crankery/lamarama/src/resource_extractor/extract/monk-strip.png

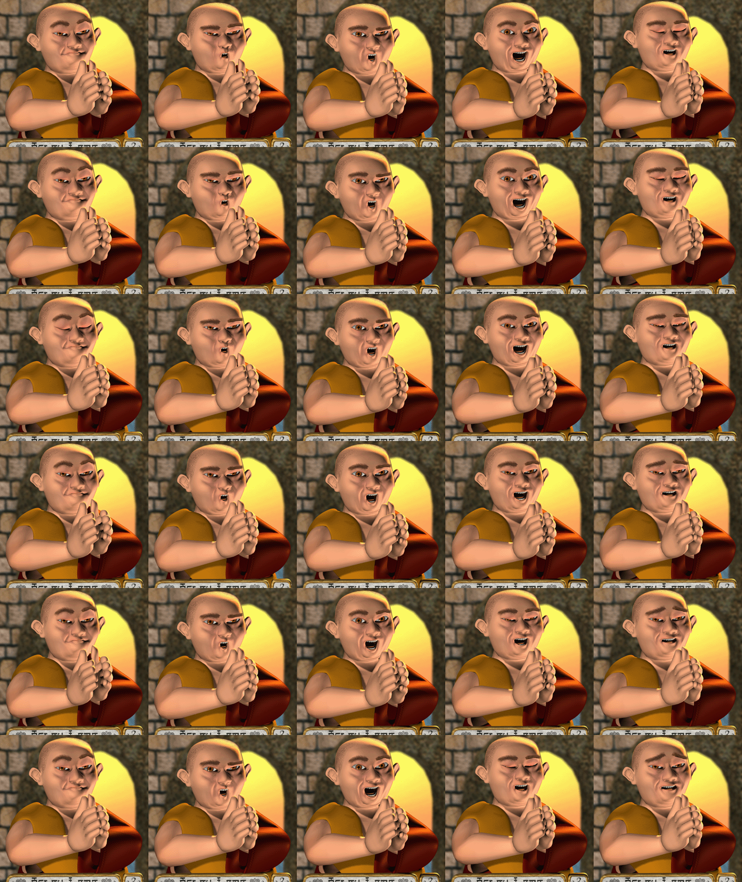
src/resource_extractor/extract/monk-strip.png
