crankery/lamarama/src/resource_extractor/extract/background.png

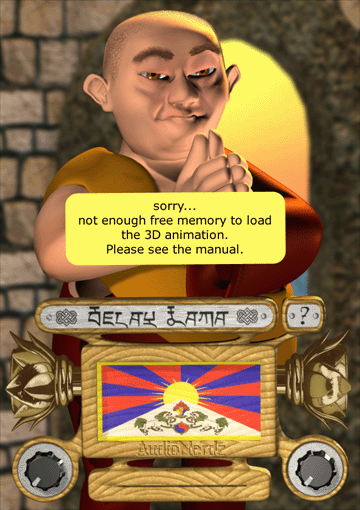
src/resource_extractor/extract/background.png
