crankery/lamarama/hw/docs/lcd.png

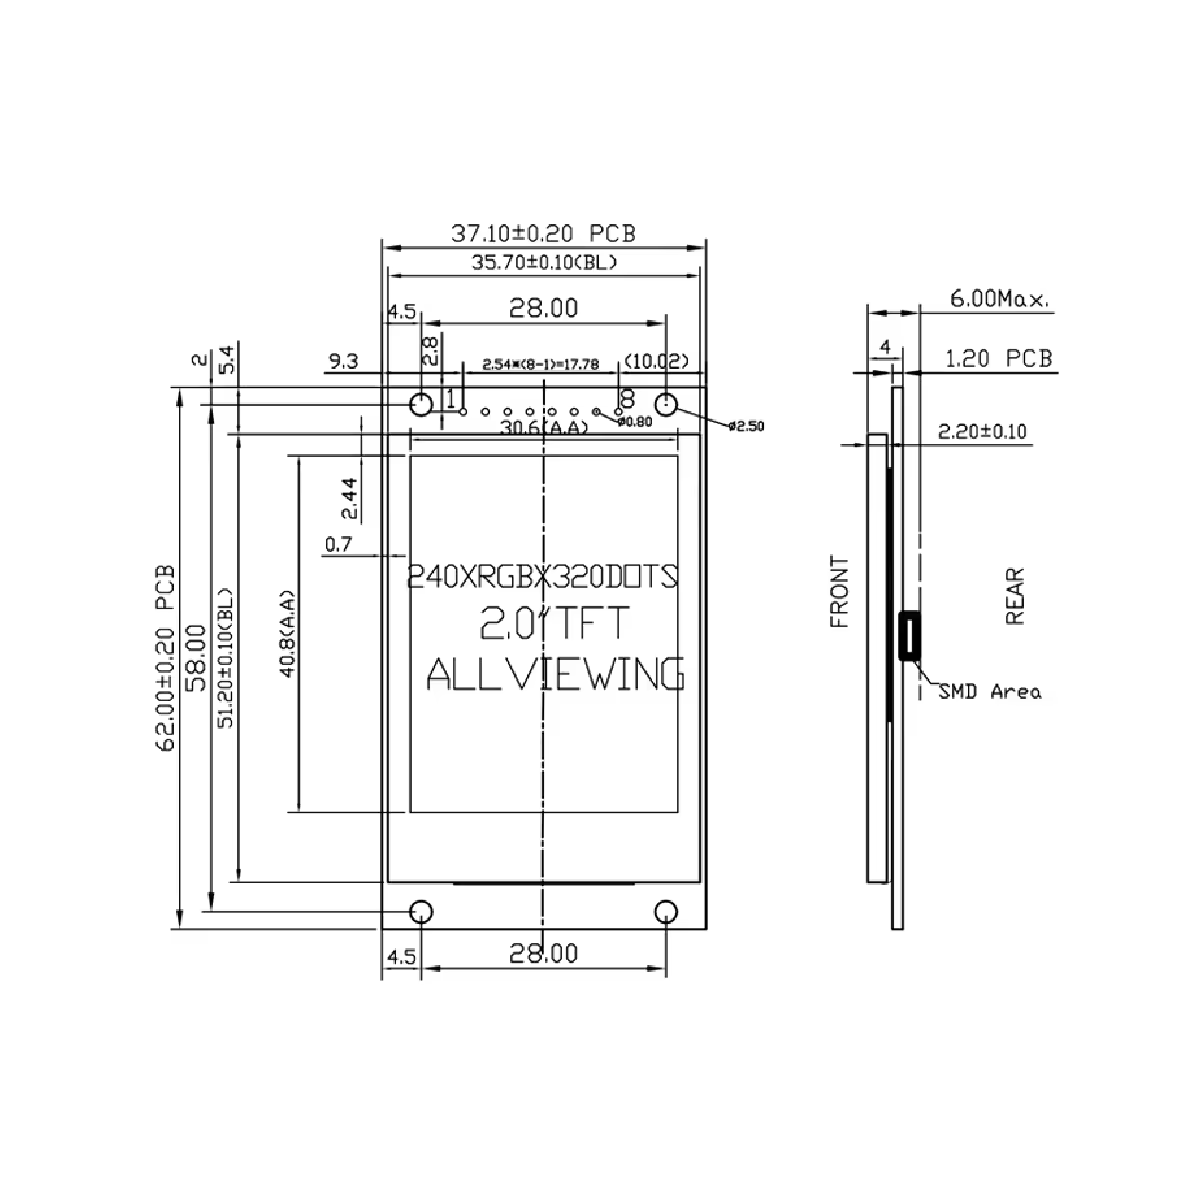
hw/docs/lcd.png
