crankery/lamarama/resources/Smug Scheming Monk Line Art.png

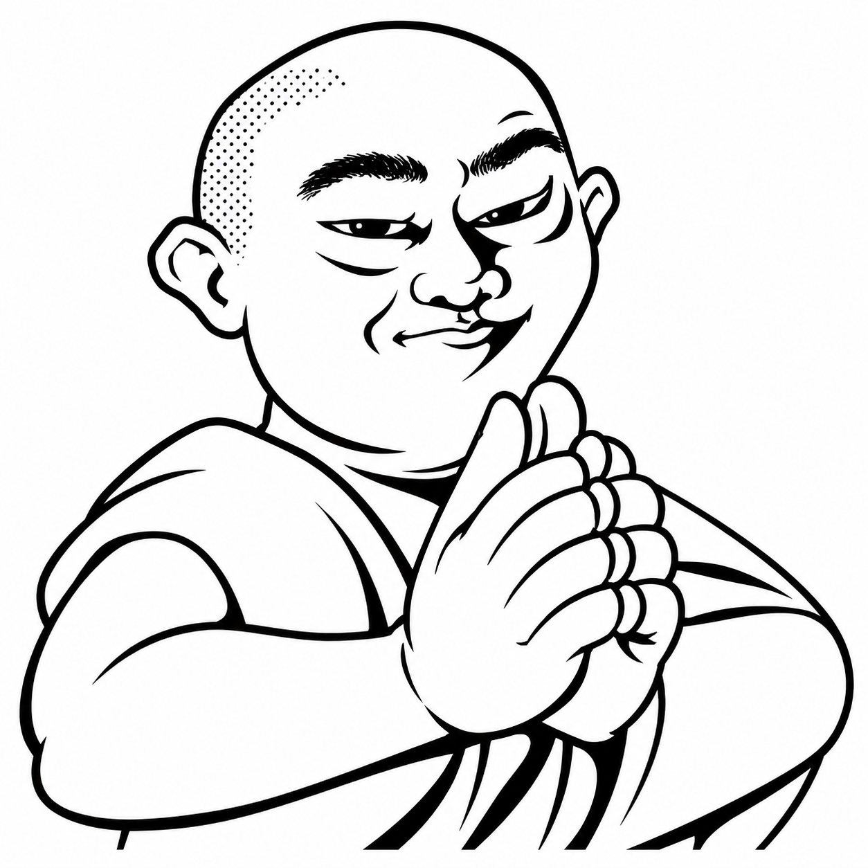
resources/Smug Scheming Monk Line Art.png
