crankery/lamarama/src/resource_extractor/extract/info.png

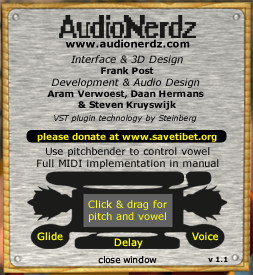
src/resource_extractor/extract/info.png
