crankery/lamarama/hw/3D/main.step

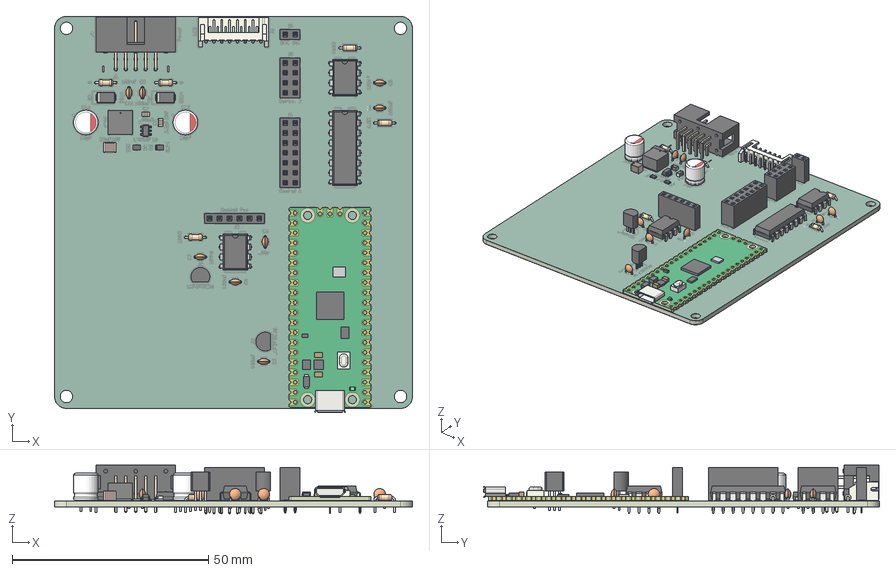
[picture p6: CAD file, 2026-10-27]
hw/3D/main.step
91.3 x 101.1 x 12.5 mm
PinSocket_2x07_P2.54mm_Vertical
C_Disc_D30mm_W16mm_P250mm x 8
D_SMA x 2
R_Axial_DIN0204_L36mm_D16mm_P508mm_Horizontal x 5
DIP-16_W7.62mm
R_0805_2012Metric x 2
JST_S8B_PH_K
C_0805_2012Metric x 2
RaspberryPi_Pico_Module_KiCad
TO-92_Inline_Narrow x 2
CAPPRD250W45D630H700_Nichicon-NS x 2
SOT-23-6
DIP-8_W7.62mm x 2
PinSocket_1x02_P2.54mm_Vertical
PinSocket_2x04_P2.54mm_Vertical
IDC_Header_2x05_P254mm_Horizontal
PinSocket_1x06_P2.54mm_Vertical
C_1210_3225Metric
main_silkscreen
main_soldermask x 2
main_PCB
