crankery/lamarama/hw/3D/fp.step

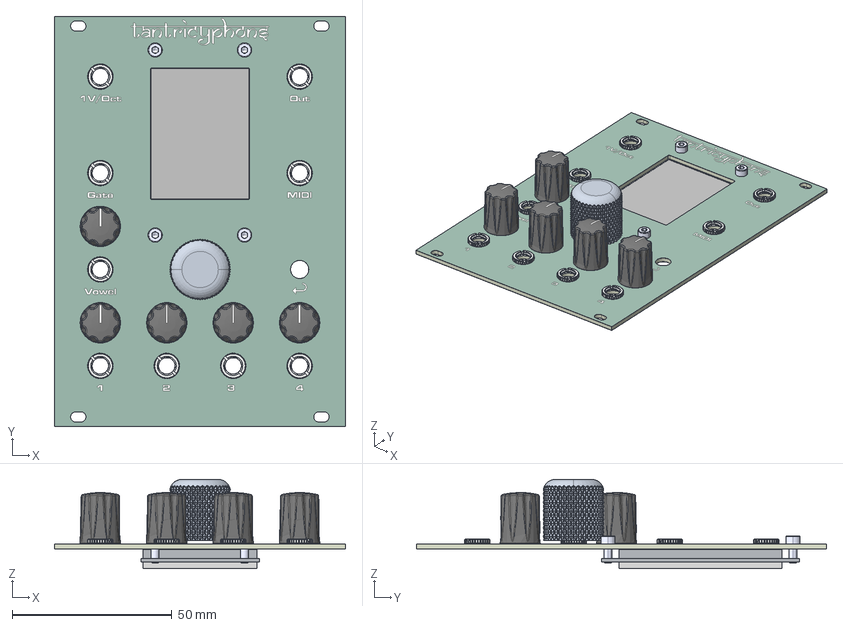
[picture p7: CAD file, 2026-10-29]
hw/3D/fp.step
91.3 x 128.5 x 28.0 mm
Dome Knob Allparts
KNUT-PJ398SM x 9
1900h-bk-T-D x 5
din912-m2.5x6 x 4
fp_silkscreen
fp_soldermask x 2
fp_PCB
