crankery/lamarama/hw/3D/Dome Knob Allparts.STEP

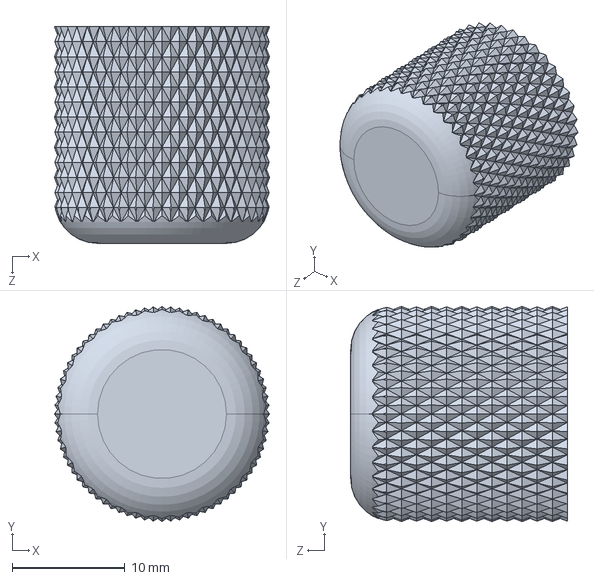
[picture p8: CAD file, 2026-10-29]
hw/3D/Dome Knob Allparts.STEP
19.1 x 19.1 x 19.2 mm
