crankery/lamarama/hw/3D/encoderknob.step

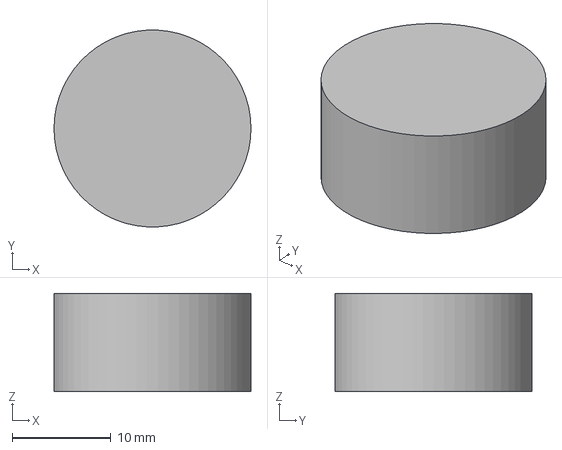
[picture p9: CAD file, 2026-10-29]
hw/3D/encoderknob.step
20.0 x 20.0 x 10.0 mm
