crankery/lamarama/hw/3D/display.step

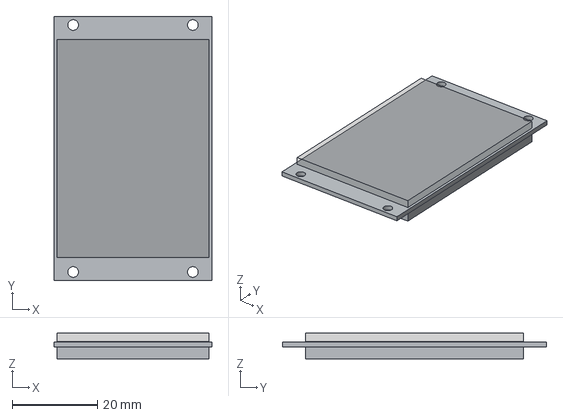
[picture p10: CAD file, 2026-10-29]
hw/3D/display.step
37.1 x 62.0 x 6.01 mm
