crankery/lamarama/hw/3D/RM065.stp

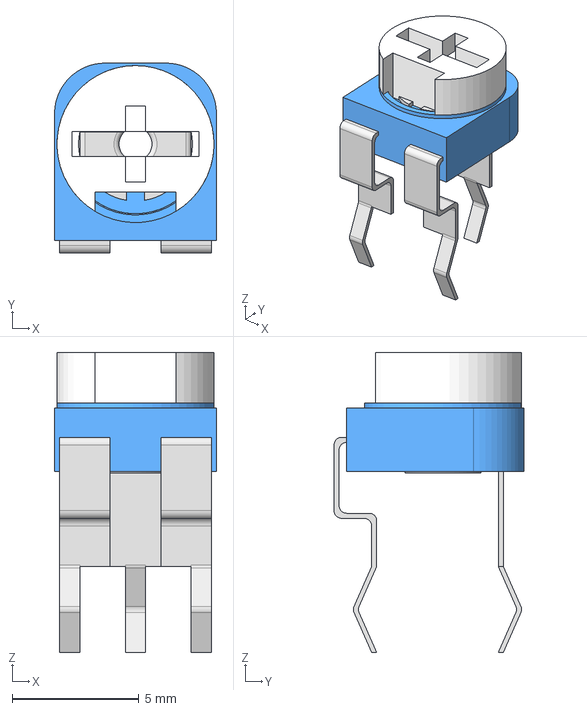
[picture p11: CAD file, 2026-10-29]
hw/3D/RM065.stp
6.40 x 7.50 x 11.9 mm
