crankery/lamarama/hw/3D/control.step

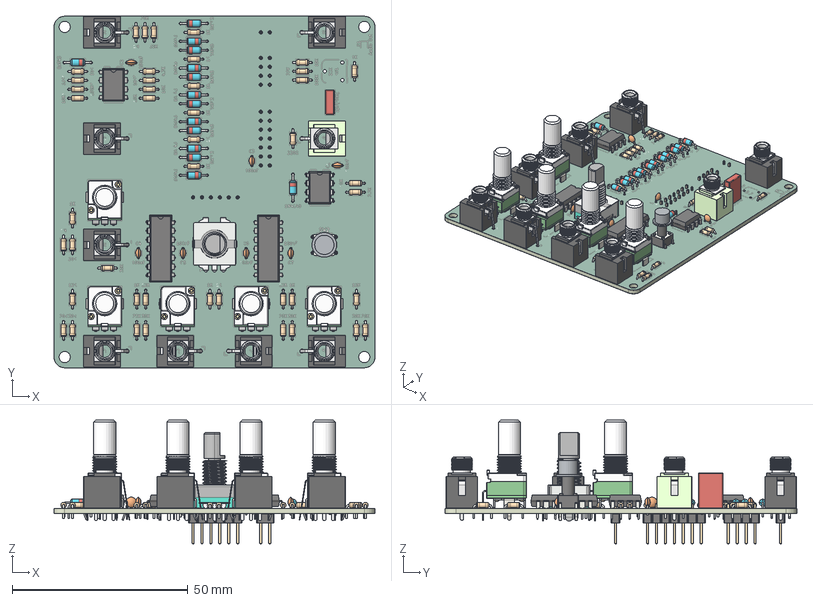
[picture p12: CAD file, 2026-10-29]
hw/3D/control.step
91.3 x 100.0 x 35.2 mm
R_Axial_DIN0204_L36mm_D16mm_P508mm_Horizontal x 44
Pin_3 x 8
Pin_2 x 8
Pin_1 x 8
Socket x 9
D_DO-35_SOD27_P7.62mm_Horizontal x 14
C_Disc_D30mm_W16mm_P250mm x 7
Pin 3
Pin 2
Pin 1
RD901F-40-15R1 v9 x 5
DIP-8_W7.62mm x 2
C_Rect_L70mm_W25mm_P500mm
SW_PUSH_6mm_h13mm
ѽת±ძǷ
DIP-14_W7.62mm x 2
PinHeader_2x04_P254mm_Vertical
PinHeader_1x02_P254mm_Vertical
PinHeader_2x07_P254mm_Vertical
PinHeader_1x06_P254mm_Vertical
control_silkscreen x 2
control_soldermask x 2
control_PCB
