crankery/lamarama/hw/3D/PJ398SM.STEP

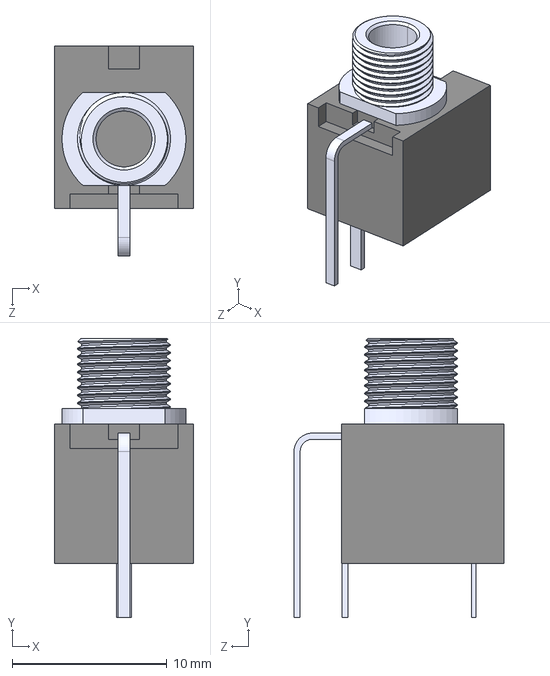
[picture p13: CAD file, 2026-10-27]
hw/3D/PJ398SM.STEP
9.00 x 18.0 x 13.5 mm
