crankery/lamarama/hw/3D/a101.FCStd

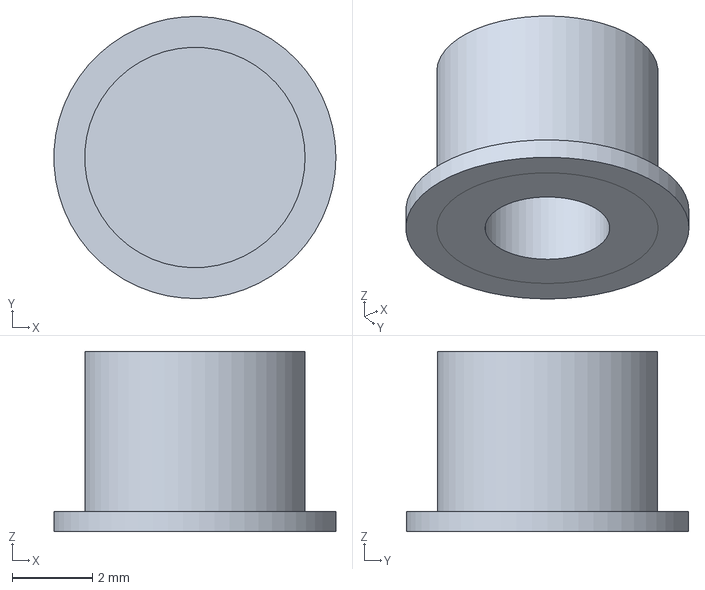
[picture p14: CAD file, 2026-10-27]
hw/3D/a101.FCStd
7.03 x 7.04 x 4.50 mm
