crankery/lamarama/hw/3D/IND_IFSC-2020DE-01_VIS.step

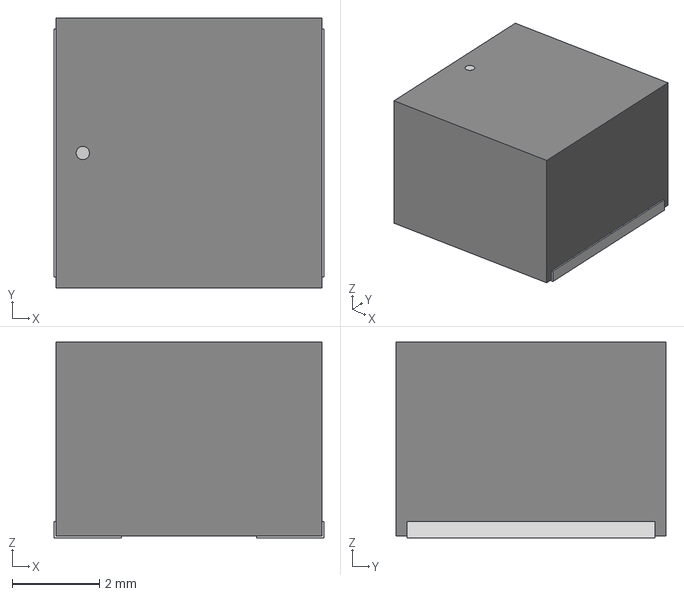
[picture p15: CAD file, 2026-10-27]
hw/3D/IND_IFSC-2020DE-01_VIS.step
6.20 x 6.20 x 4.50 mm
