crankery/lamarama/hw/3D/CAPPRD250W45D630H700_Nichicon-NS.stp

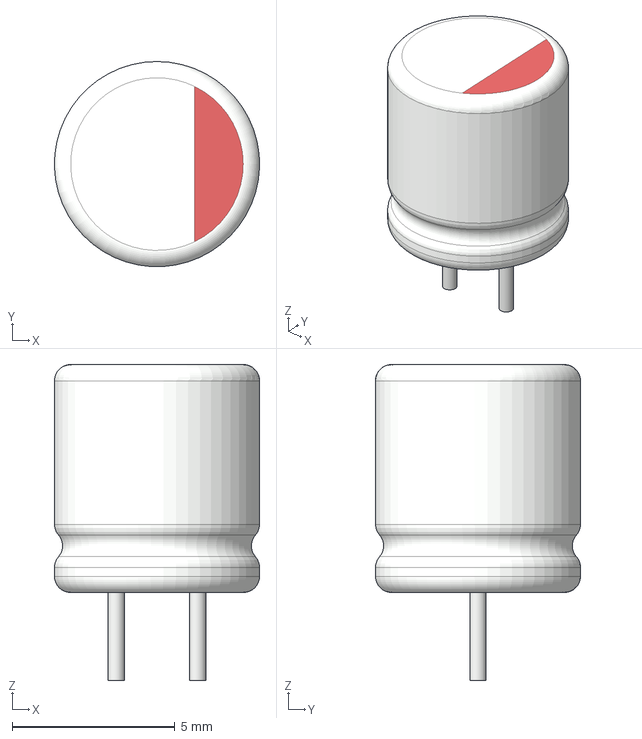
[picture p16: CAD file, 2026-10-27]
hw/3D/CAPPRD250W45D630H700_Nichicon-NS.stp
6.30 x 6.29 x 9.70 mm
