crankery/lamarama/hw/3D/din912-m2.5x6.STEP

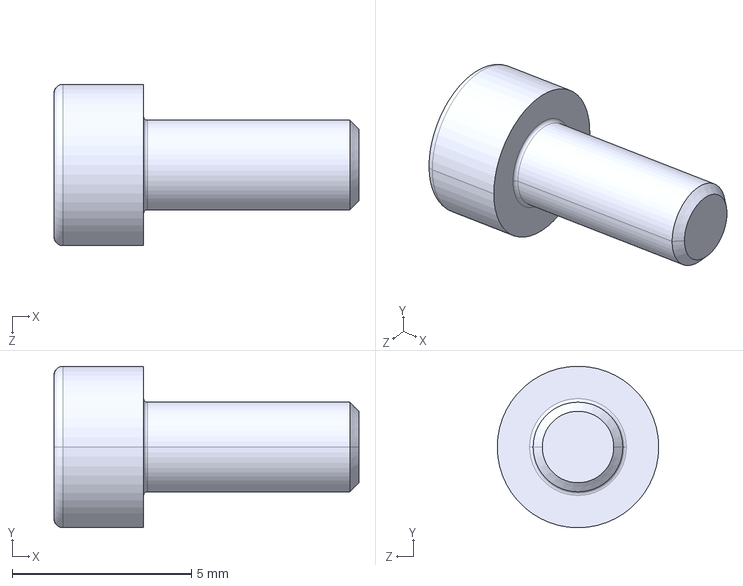
[picture p17: CAD file, 2026-10-29]
hw/3D/din912-m2.5x6.STEP
8.50 x 4.50 x 4.50 mm
