crankery/lamarama/hw/3D/encoderknob.scad

$fn = 32;

color("grey")
  cylinder(h = 10, r = 10);
