crankery/lamarama/(list of files, cad)

Other CAD files:
hw/3D/Unnamed-difference.step
hw/3D/a101.stl
