crankery/lamarama/hw/control/control.kicad_pcb

## KiCad design hw/control/control.kicad_pcb (2026-10-29)

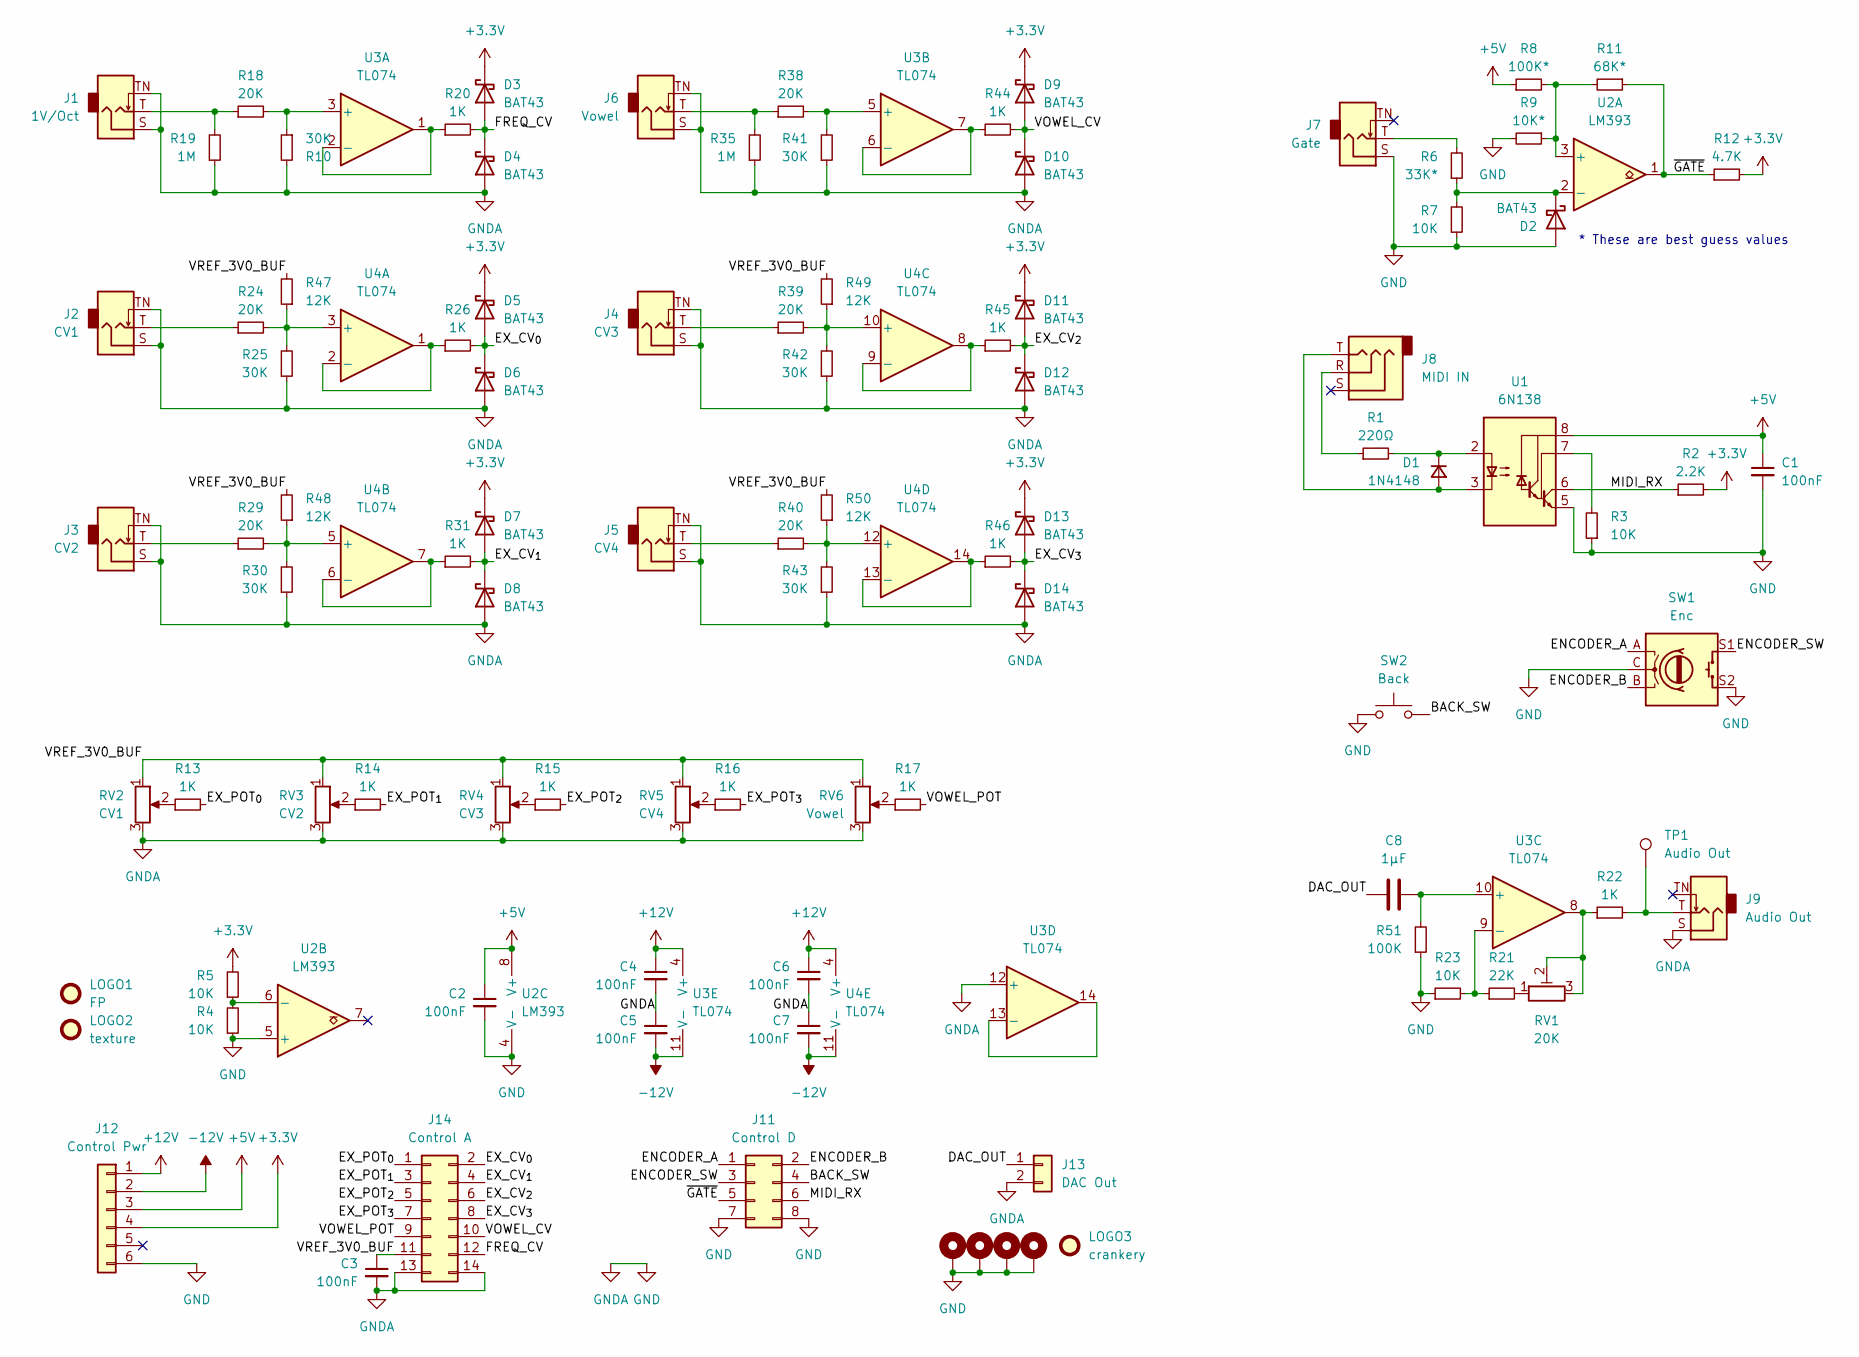
[picture p18: schematic control.kicad_sch]

Parts:
C1, C2, C3, C4, C5, C6, C7: 100nF; C_Disc_D3.0mm_W1.6mm_P2.50mm
C8: 1µF; C_Rect_L7.0mm_W2.5mm_P5.00mm
D1: 1N4148; D_DO-35_SOD27_P7.62mm_Horizontal
D2, D3, D4, D5, D6, D7, D8, D9, D10, D11, D12, D13, D14: BAT43; D_DO-35_SOD27_P7.62mm_Horizontal
H1, H2, H3, H4: MountingHole_Pad; MountingHole_3.2mm_M3_DIN965_Pad
J1: 1V/Oct; Jack_PJ398SM
J2: CV1; Jack_PJ398SM
J3: CV2; Jack_PJ398SM
J4: CV3; Jack_PJ398SM
J5: CV4; Jack_PJ398SM
J6: Vowel; Jack_PJ398SM
J7: Gate; Jack_PJ398SM
J8: MIDI IN; Jack_P419_GR
J9: Audio Out; Jack_PJ398SM
J11: Control D; PinHeader_2x04_P2.54mm_Vertical
J12: Control Pwr; PinHeader_1x06_P2.54mm_Vertical
J13: DAC Out; PinHeader_1x02_P2.54mm_Vertical
J14: Control A; PinHeader_2x07_P2.54mm_Vertical
LOGO1: FP; fp
LOGO2: texture; hammeredx
LOGO3: crankery; crankery_small
R1: 220Ω; R_Axial_DIN0204_L3.6mm_D1.6mm_P5.08mm_Horizontal
R2: 2.2K; R_Axial_DIN0204_L3.6mm_D1.6mm_P5.08mm_Horizontal
R3, R4, R5, R7, R23: 10K; R_Axial_DIN0204_L3.6mm_D1.6mm_P5.08mm_Horizontal
R6: 33K*; R_Axial_DIN0204_L3.6mm_D1.6mm_P5.08mm_Horizontal
R8: 100K*; R_Axial_DIN0204_L3.6mm_D1.6mm_P5.08mm_Horizontal
R9: 10K*; R_Axial_DIN0204_L3.6mm_D1.6mm_P5.08mm_Horizontal
R10, R25, R30, R41, R42, R43: 30K; R_Axial_DIN0204_L3.6mm_D1.6mm_P5.08mm_Horizontal
R11: 68K*; R_Axial_DIN0204_L3.6mm_D1.6mm_P5.08mm_Horizontal
R12: 4.7K; R_Axial_DIN0204_L3.6mm_D1.6mm_P5.08mm_Horizontal
R13, R14, R15, R16, R17, R20, R22, R26, R31, R44, R45, R46: 1K; R_Axial_DIN0204_L3.6mm_D1.6mm_P5.08mm_Horizontal
R18, R24, R29, R38, R39, R40: 20K; R_Axial_DIN0204_L3.6mm_D1.6mm_P5.08mm_Horizontal
R19, R35: 1M; R_Axial_DIN0204_L3.6mm_D1.6mm_P5.08mm_Horizontal
R21: 22K; R_Axial_DIN0204_L3.6mm_D1.6mm_P5.08mm_Horizontal
R47, R48, R49, R50: 12K; R_Axial_DIN0204_L3.6mm_D1.6mm_P5.08mm_Horizontal
R51: 100K; R_Axial_DIN0204_L3.6mm_D1.6mm_P5.08mm_Horizontal
RV1: 20K; Potentiometer_Runtron_RM-065_Vertical
RV2: CV1; Potentiometer_Alpha_RD901F-40-00D_Single_Vertical
RV3: CV2; Potentiometer_Alpha_RD901F-40-00D_Single_Vertical
RV4: CV3; Potentiometer_Alpha_RD901F-40-00D_Single_Vertical
RV5: CV4; Potentiometer_Alpha_RD901F-40-00D_Single_Vertical
RV6: Vowel; Potentiometer_Alpha_RD901F-40-00D_Single_Vertical
SW1: Enc; RotaryEncoder_Alps_EC11E-Switch_Vertical_H20mm
SW2: Back; SW_PUSH_6mm_H13mm
TP1: Audio Out; TestPoint_Pad_1.5x1.5mm
U1: 6N138; DIP-8_W7.62mm
U2: LM393; DIP-8_W7.62mm
U3, U4: TL074; DIP-14_W7.62mm

Connections:
+3.3V: D3.1 (K), D5.1 (K), D7.1 (K), D9.1 (K), D11.1 (K), D13.1 (K), J12.4, R2.2, R5.2, R12.2
+5V: C1.1, C2.1, J12.3, R8.1, U1.8 (VCC), U2.8 (V+)
+12V: C4.1, C6.1, J12.1, U3.4 (V+), U4.4 (V+)
-12V: C5.2, C7.2, J12.2, U3.11 (V-), U4.11 (V-)
/BACK_SW: J11.4, SW2.2
/DAC_OUT: C8.1, J13.1
/ENCODER_A: J11.1, SW1.A
/ENCODER_B: J11.2, SW1.B
/ENCODER_SW: J11.3, SW1.S1
/EX_CV_{0}: D5.2 (A), D6.1 (K), J14.2, R26.2
/EX_CV_{1}: D7.2 (A), D8.1 (K), J14.4, R31.2
/EX_CV_{2}: D11.2 (A), D12.1 (K), J14.6, R45.2
/EX_CV_{3}: D13.2 (A), D14.1 (K), J14.8, R46.2
/EX_POT_{0}: J14.1, R13.2
/EX_POT_{1}: J14.3, R14.2
/EX_POT_{2}: J14.5, R15.2
/EX_POT_{3}: J14.7, R16.2
/FREQ_CV: D3.2 (A), D4.1 (K), J14.12, R20.2
/MIDI_RX: J11.6, R2.1, U1.6 (VO2)
/VOWEL_CV: D9.2 (A), D10.1 (K), J14.10, R44.2
/VOWEL_POT: J14.9, R17.2
/VREF_3V0_BUF: C3.1, J14.11, R47.2, R48.2, R49.2, R50.2, RV2.1, RV3.1, RV4.1, RV5.1, RV6.1
/~GATE: J11.5, R11.1, R12.1, U2.1
GND: C1.2, C2.2, C3.2, C4.2, C5.1, C6.2, C7.1, D2.2 (A), D4.2 (A), D6.2 (A), D8.2 (A), D10.2 (A), D12.2 (A), D14.2 (A), H1.1 (1_1), H2.1 (1_1), H3.1 (1_1), H4.1 (1_1), J1.S, J1.TN, J2.S, J2.TN, J3.S, J3.TN, J4.S, J4.TN, J5.S, J5.TN, J6.S, J6.TN, J7.S, J9.S, J11.7, J11.8, J12.6, J13.2, J14.13, J14.14, R3.1, R4.1, R7.1, R9.2, R10.2, R19.1, R23.1, R25.1, R30.1, R35.1, R41.1, R42.1, R43.1, R51.1, RV2.3, RV3.3, RV4.3, RV5.3, RV6.3, SW1.C, SW1.S2, SW2.1, U1.5 (GND), U2.4 (V-), U2.5 (+), U3.12 (+)
unnamed: D1.2 (A), J8.T, U1.3 (C2)
unnamed: D1.1 (K), R1.2, U1.2 (C1)
unnamed: D2.1 (K), R6.1, R7.2, U2.2 (-)
unnamed: J1.T, R18.1, R19.2
unnamed: J2.T, R24.1
unnamed: J3.T, R29.1
unnamed: J4.T, R39.1
unnamed: J5.T, R40.1
unnamed: J6.T, R35.2, R38.1
unnamed: J7.T, R6.2
unnamed: J8.R, R1.1
unnamed: J9.T, R22.2, TP1.1 (1_1)
unnamed: R13.1, RV2.2
unnamed: R14.1, RV3.2
unnamed: R15.1, RV4.2
unnamed: R16.1, RV5.2
unnamed: R17.1, RV6.2
unnamed: R21.2, RV1.1
unnamed: R22.1, RV1.2, RV1.3, U3.8
unnamed: R3.2, U1.7 (VO1)
unnamed: R8.2, R9.1, R11.2, U2.3 (+)
unnamed: R4.2, R5.1, U2.6 (-)
unnamed: R10.1, R18.2, U3.3 (+)
unnamed: R20.1, U3.1, U3.2 (-)
unnamed: R38.2, R41.2, U3.5 (+)
unnamed: R44.1, U3.6 (-), U3.7
unnamed: C8.2, R51.2, U3.10 (+)
unnamed: R21.1, R23.2, U3.9 (-)
unnamed: U3.13 (-), U3.14
unnamed: R24.2, R25.2, R47.1, U4.3 (+)
unnamed: R26.1, U4.1, U4.2 (-)
unnamed: R29.2, R30.2, R48.1, U4.5 (+)
unnamed: R31.1, U4.6 (-), U4.7
unnamed: R39.2, R42.2, R49.1, U4.10 (+)
unnamed: R45.1, U4.8, U4.9 (-)
unnamed: R40.2, R43.2, R50.1, U4.12 (+)
unnamed: R46.1, U4.13 (-), U4.14

Notes on the sheet:
* These are best guess values

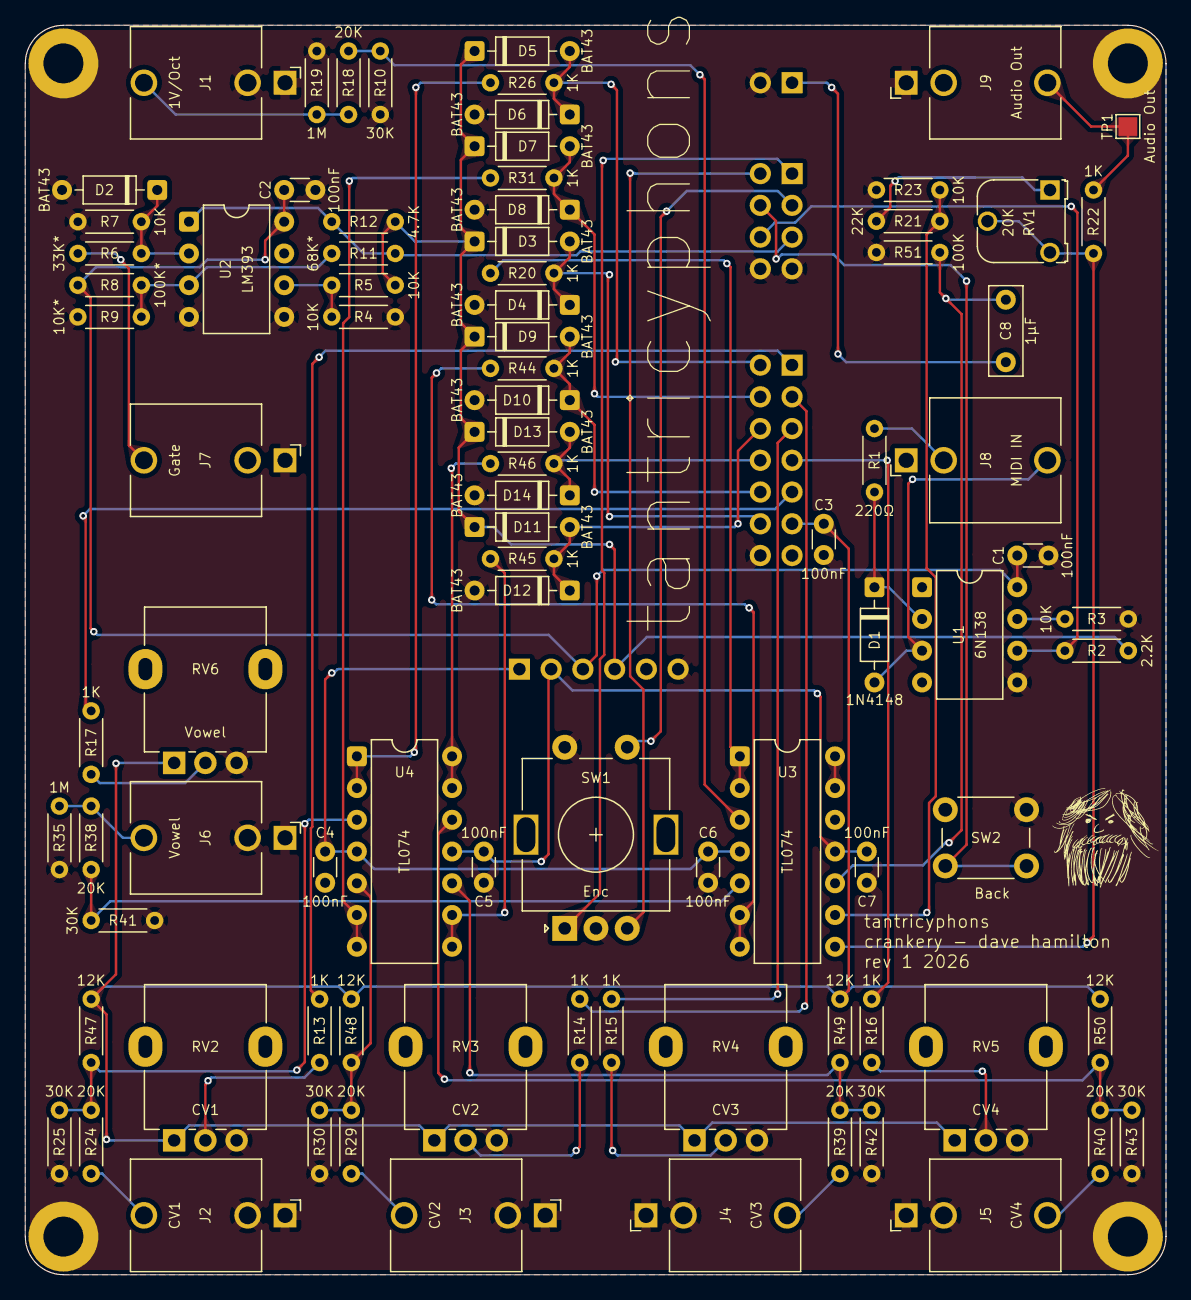
[picture p19: board control.kicad_pcb from above]

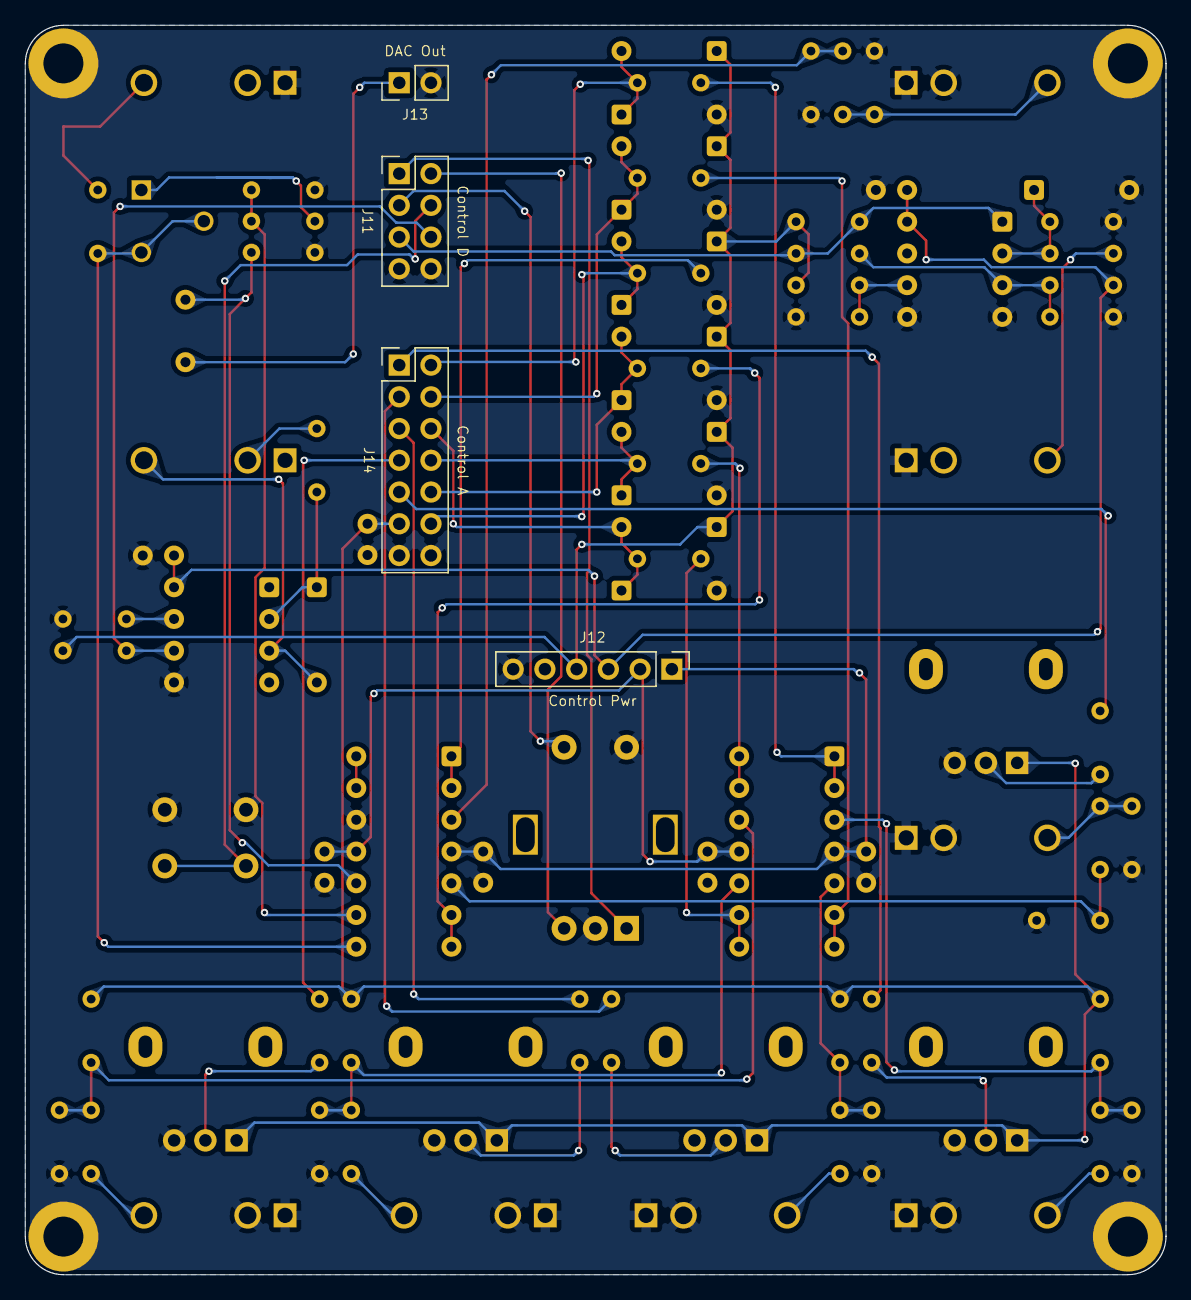
[picture p20: board control.kicad_pcb from below]

Board: 2 copper layers, 91.3 x 100.0 mm, 98 parts (4 on the bottom side), 61 nets.
