crankery/lamarama/hw/main/main.kicad_pcb

## KiCad design hw/main/main.kicad_pcb (2026-10-29)

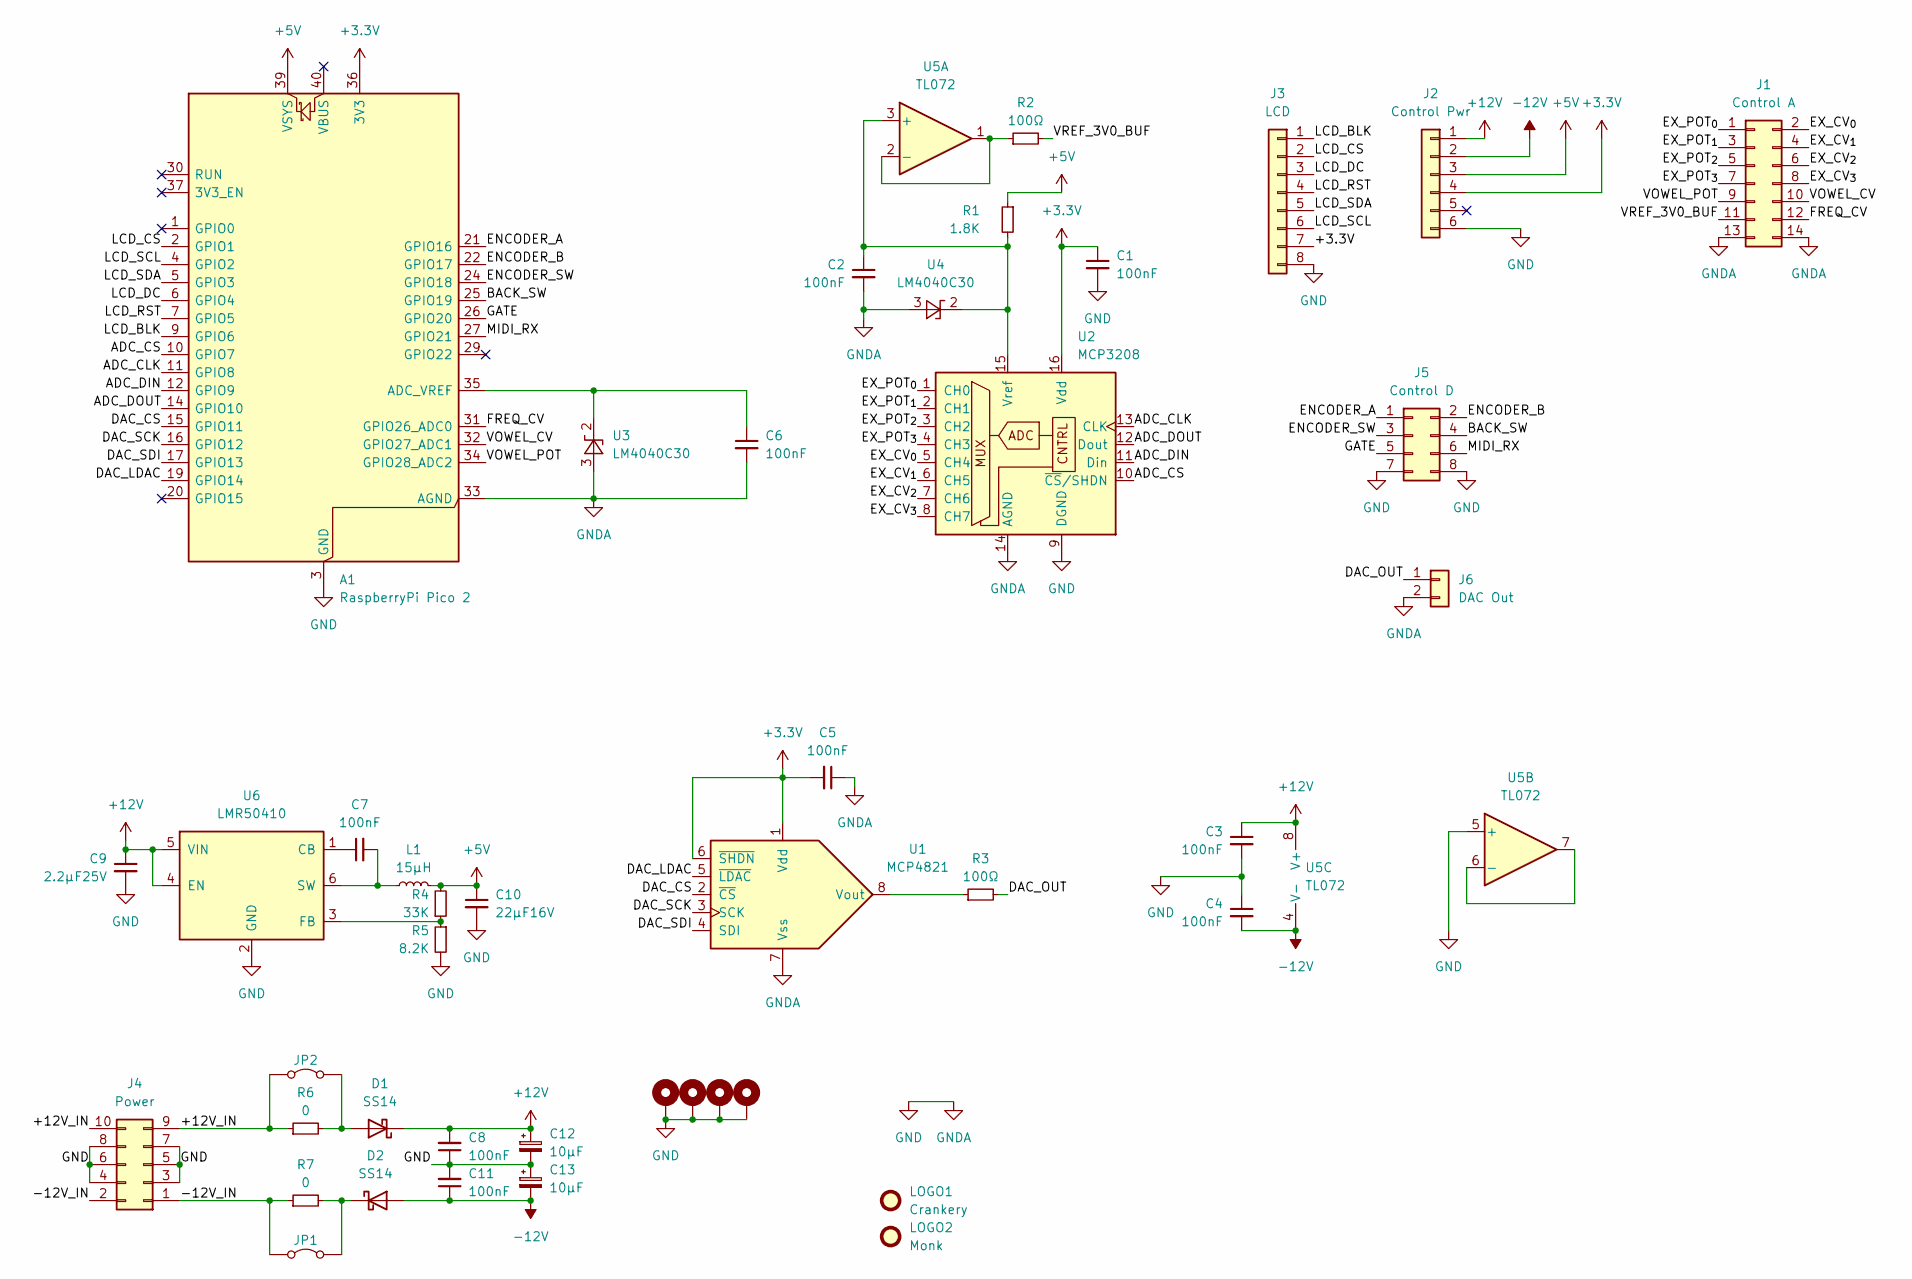
[picture p21: schematic main.kicad_sch]

Parts:
A1: RaspberryPi Pico 2; RaspberryPi_Pico_SMD
C1, C2, C3, C4, C5, C6, C8, C11: 100nF; C_Disc_D3.0mm_W1.6mm_P2.50mm
C7: 100nF; C_0805_2012Metric_Pad1.18x1.45mm_HandSolder
C9: 2.2µF25V; C_0805_2012Metric_Pad1.18x1.45mm_HandSolder
C10: 22µF16V; C_1210_3225Metric_Pad1.33x2.70mm_HandSolder
C12, C13: 10µF; CP_Radial_D6.3mm_P2.50mm
D1, D2: SS14; D_SMA
H1, H2, H3, H4: MountingHole_Pad; MountingHole_3.2mm_M3_DIN965_Pad
J1: Control A; PinSocket_2x07_P2.54mm_Vertical
J2: Control Pwr; PinSocket_1x06_P2.54mm_Vertical
J3: LCD; JST_PH_S8B-PH-K_1x08_P2.00mm_Horizontal
J4: Power; IDC-Header_2x05_P2.54mm_Horizontal
J5: Control D; PinSocket_2x04_P2.54mm_Vertical
J6: DAC Out; PinSocket_1x02_P2.54mm_Vertical
JP1, JP2: Jumper_2_Bridged; SolderJumper-2_P1.3mm_Bridged_RoundedPad1.0x1.5mm
L1: 15µH; L_TDK_VLS6045EX_VLS6045AF
LOGO1: Crankery; crankery_small
LOGO2: Monk; monk
R1: 1.8K; R_Axial_DIN0204_L3.6mm_D1.6mm_P5.08mm_Horizontal
R2, R3: 100Ω; R_Axial_DIN0204_L3.6mm_D1.6mm_P5.08mm_Horizontal
R4: 33K; R_0805_2012Metric_Pad1.20x1.40mm_HandSolder
R5: 8.2K; R_0805_2012Metric_Pad1.20x1.40mm_HandSolder
R6, R7: 0; R_Axial_DIN0204_L3.6mm_D1.6mm_P5.08mm_Horizontal
U1: MCP4821; DIP-8_W7.62mm
U2: MCP3208; DIP-16_W7.62mm
U3, U4: LM4040C30; TO-92_Inline
U5: TL072; DIP-8_W7.62mm
U6: LMR50410; SOT-23-6

Connections:
+3.3V: A1.36 (3V3), C1.1, C5.2, J2.4, J3.7, U1.1 (Vdd), U1.6 (~SHDN), U2.16 (Vdd)
+5V: A1.39 (VSYS), C10.1, J2.3, L1.2, R1.1, R4.2
+12V: C3.1, C8.2, C9.1, C12.1, D1.1 (K), J2.1, U5.8 (V+), U6.4 (EN), U6.5 (VIN)
-12V: C4.2, C11.1, C13.2, D2.2 (A), J2.2, U5.4 (V-)
/+12V_IN: J4.9, J4.10, JP2.1 (A), R6.1
/-12V_IN: J4.1, J4.2, JP1.1 (A), R7.1
/ADC_CLK: A1.11 (GPIO8), U2.13 (CLK)
/ADC_CS: A1.10 (GPIO7), U2.10 (~CS/SHDN)
/ADC_DIN: A1.12 (GPIO9), U2.11 (Din)
/ADC_DOUT: A1.14 (GPIO10), U2.12 (Dout)
/BACK_SW: A1.25 (GPIO19), J5.4
/DAC_CS: A1.15 (GPIO11), U1.2 (~CS)
/DAC_LDAC: A1.19 (GPIO14), U1.5 (~LDAC)
/DAC_OUT: J6.1, R3.2
/DAC_SCK: A1.16 (GPIO12), U1.3 (SCK)
/DAC_SDI: A1.17 (GPIO13), U1.4 (SDI)
/ENCODER_A: A1.21 (GPIO16), J5.1
/ENCODER_B: A1.22 (GPIO17), J5.2
/ENCODER_SW: A1.24 (GPIO18), J5.3
/EX_CV_{0}: J1.2, U2.5 (CH4)
/EX_CV_{1}: J1.4, U2.6 (CH5)
/EX_CV_{2}: J1.6, U2.7 (CH6)
/EX_CV_{3}: J1.8, U2.8 (CH7)
/EX_POT_{0}: J1.1, U2.1 (CH0)
/EX_POT_{1}: J1.3, U2.2 (CH1)
/EX_POT_{2}: J1.5, U2.3 (CH2)
/EX_POT_{3}: J1.7, U2.4 (CH3)
/FREQ_CV: A1.31 (GPIO26_ADC0), J1.12
/GATE: A1.26 (GPIO20), J5.5
/LCD_BLK: A1.9 (GPIO6), J3.1
/LCD_CS: A1.2 (GPIO1), J3.2
/LCD_DC: A1.6 (GPIO4), J3.3
/LCD_RST: A1.7 (GPIO5), J3.4
/LCD_SCL: A1.4 (GPIO2), J3.6
/LCD_SDA: A1.5 (GPIO3), J3.5
/MIDI_RX: A1.27 (GPIO21), J5.6
/VOWEL_CV: A1.32 (GPIO27_ADC1), J1.10
/VOWEL_POT: A1.34 (GPIO28_ADC2), J1.9
/VREF_3V0_BUF: J1.11, R2.2
GND: A1.3 (GND), A1.8 (GND), A1.13 (GND), A1.18 (GND), A1.23 (GND), A1.28 (GND), A1.33 (AGND), A1.38 (GND), C1.2, C2.2, C3.2, C4.1, C5.1, C6.2, C8.1, C9.2, C10.2, C11.2, C12.2, C13.1, H1.1 (1_1), H2.1 (1_1), H3.1 (1_1), H4.1 (1_1), J1.13, J1.14, J2.6, J3.8, J4.3, J4.4, J4.5, J4.6, J4.7, J4.8, J5.7, J5.8, J6.2, R5.2, U1.7 (Vss), U2.9 (DGND), U2.14 (AGND), U3.3 (A), U4.3 (A), U5.5 (+), U6.2 (GND)
unnamed: A1.35 (ADC_VREF), C6.1, U3.2 (K)
unnamed: D1.2 (A), JP2.2 (B), R6.2
unnamed: D2.1 (K), JP1.2 (B), R7.2
unnamed: R3.1, U1.8 (Vout)
unnamed: C2.1, R1.2, U2.15 (Vref), U4.2 (K), U5.3 (+)
unnamed: R2.1, U5.1, U5.2 (-)
unnamed: U5.6 (-), U5.7
unnamed: C7.1, U6.1 (CB)
unnamed: R4.1, R5.1, U6.3 (FB)
unnamed: C7.2, L1.1, U6.6 (SW)

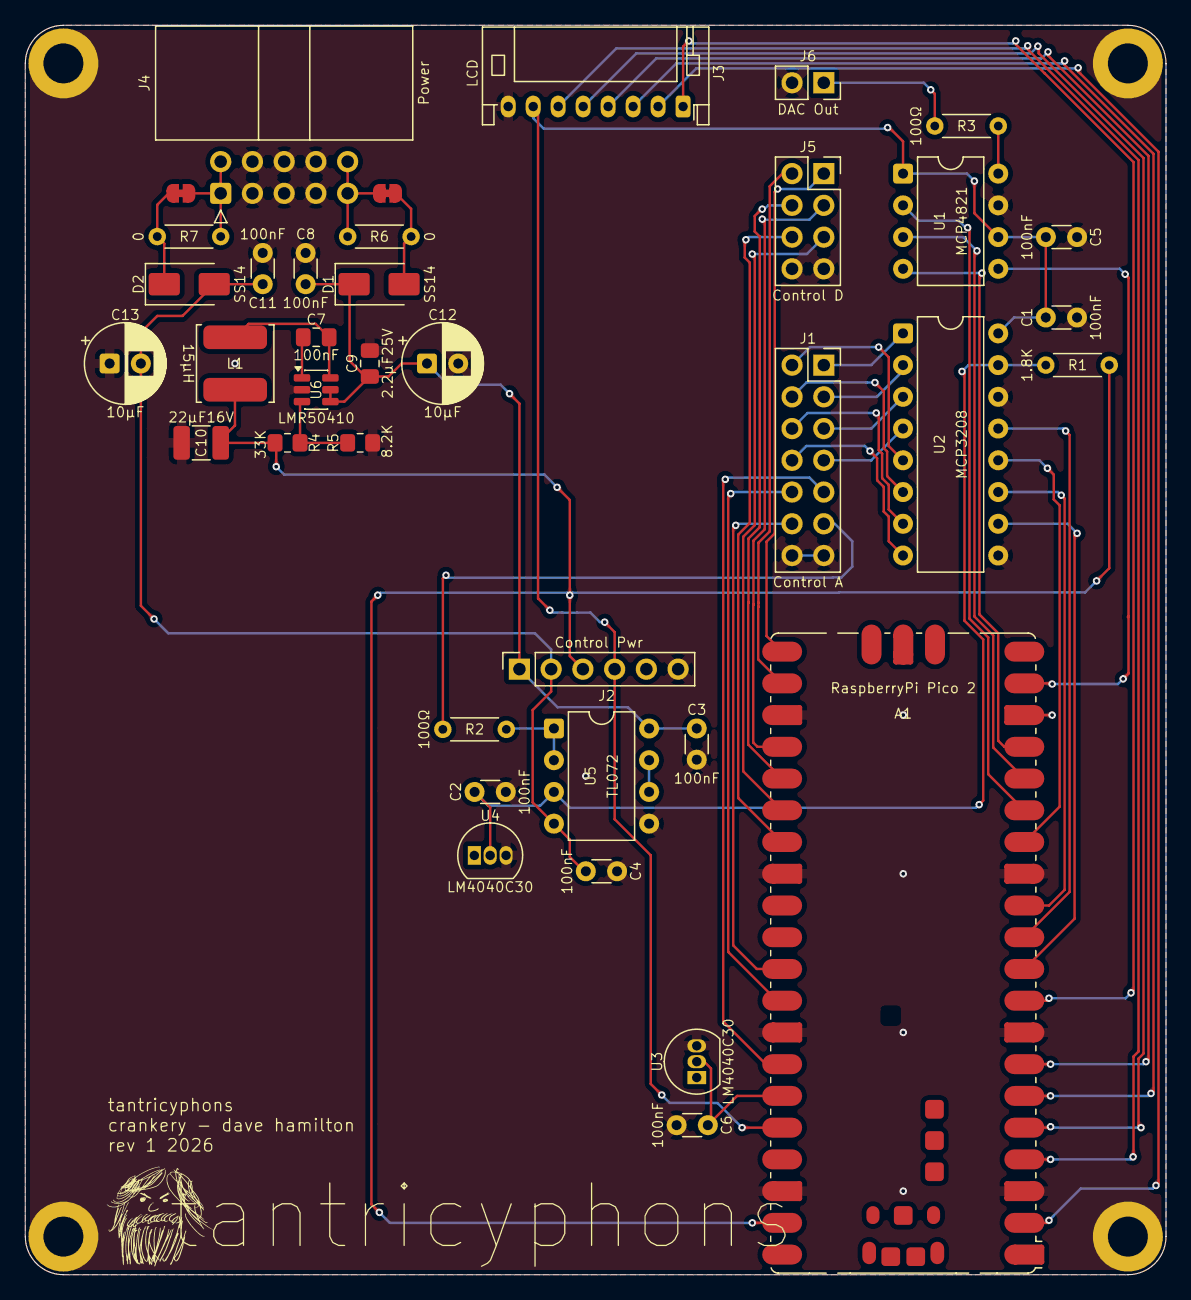
[picture p22: board main.kicad_pcb from above]

Board: 2 copper layers, 91.3 x 100.0 mm, 44 parts (1 on the bottom side), 50 nets.
