crankery/lamarama/src/lama/menu_font.h

/* 8x8 font from st7789_mpy; see assets/font-LICENSE.txt. */
// clang-format off
static const unsigned char menu_font[96][8] = {{0, 0, 0, 0, 0, 0, 0, 0},
                                               {24, 60, 60, 24, 24, 0, 24, 0},
                                               {102, 102, 36, 0, 0, 0, 0, 0},
                                               {108, 108, 254, 108, 254, 108, 108, 0},
                                               {24, 62, 96, 60, 6, 124, 24, 0},
                                               {0, 198, 204, 24, 48, 102, 198, 0},
                                               {56, 108, 56, 118, 220, 204, 118, 0},
                                               {24, 24, 48, 0, 0, 0, 0, 0},
                                               {12, 24, 48, 48, 48, 24, 12, 0},
                                               {48, 24, 12, 12, 12, 24, 48, 0},
                                               {0, 102, 60, 255, 60, 102, 0, 0},
                                               {0, 24, 24, 126, 24, 24, 0, 0},
                                               {0, 0, 0, 0, 0, 24, 24, 48},
                                               {0, 0, 0, 126, 0, 0, 0, 0},
                                               {0, 0, 0, 0, 0, 24, 24, 0},
                                               {6, 12, 24, 48, 96, 192, 128, 0},
                                               {56, 108, 198, 214, 198, 108, 56, 0},
                                               {24, 56, 24, 24, 24, 24, 126, 0},
                                               {124, 198, 6, 28, 48, 102, 254, 0},
                                               {124, 198, 6, 60, 6, 198, 124, 0},
                                               {28, 60, 108, 204, 254, 12, 30, 0},
                                               {254, 192, 192, 252, 6, 198, 124, 0},
                                               {56, 96, 192, 252, 198, 198, 124, 0},
                                               {254, 198, 12, 24, 48, 48, 48, 0},
                                               {124, 198, 198, 124, 198, 198, 124, 0},
                                               {124, 198, 198, 126, 6, 12, 120, 0},
                                               {0, 24, 24, 0, 0, 24, 24, 0},
                                               {0, 24, 24, 0, 0, 24, 24, 48},
                                               {6, 12, 24, 48, 24, 12, 6, 0},
                                               {0, 0, 126, 0, 0, 126, 0, 0},
                                               {96, 48, 24, 12, 24, 48, 96, 0},
                                               {124, 198, 12, 24, 24, 0, 24, 0},
                                               {124, 198, 222, 222, 222, 192, 120, 0},
                                               {56, 108, 198, 254, 198, 198, 198, 0},
                                               {252, 102, 102, 124, 102, 102, 252, 0},
                                               {60, 102, 192, 192, 192, 102, 60, 0},
                                               {248, 108, 102, 102, 102, 108, 248, 0},
                                               {254, 98, 104, 120, 104, 98, 254, 0},
                                               {254, 98, 104, 120, 104, 96, 240, 0},
                                               {60, 102, 192, 192, 206, 102, 58, 0},
                                               {198, 198, 198, 254, 198, 198, 198, 0},
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

// clang-format on
