crankery/lamarama/src/lama/settings_storage.h

#ifndef LAMA_SETTINGS_STORAGE_H
#define LAMA_SETTINGS_STORAGE_H
#include "settings_format.h"
const uint8_t *settings_flash_read(unsigned slot);
bool settings_flash_write(unsigned slot, const uint8_t page[SETTINGS_PAGE_SIZE]);
#endif
